sbalneav/rummikub-shot-clock/schematic/schematic.pdf

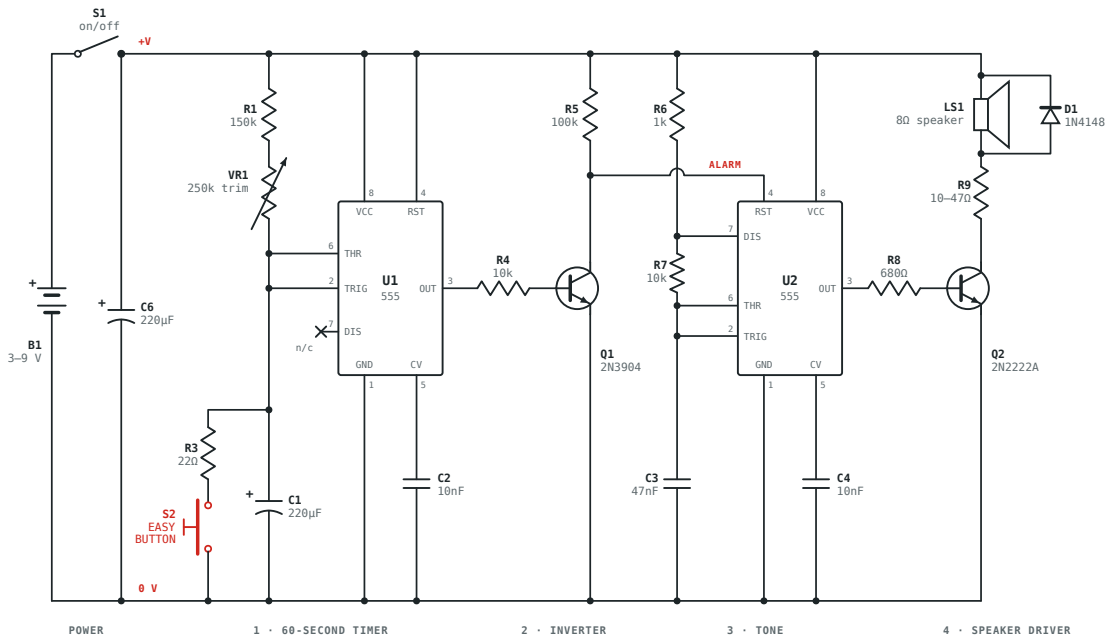
[picture p5: page 1]
