sbalneav/rummikub-shot-clock/pcb/rummikub-shot-clock.kicad_pcb

## KiCad design pcb/rummikub-shot-clock.kicad_pcb (2026-11-11)

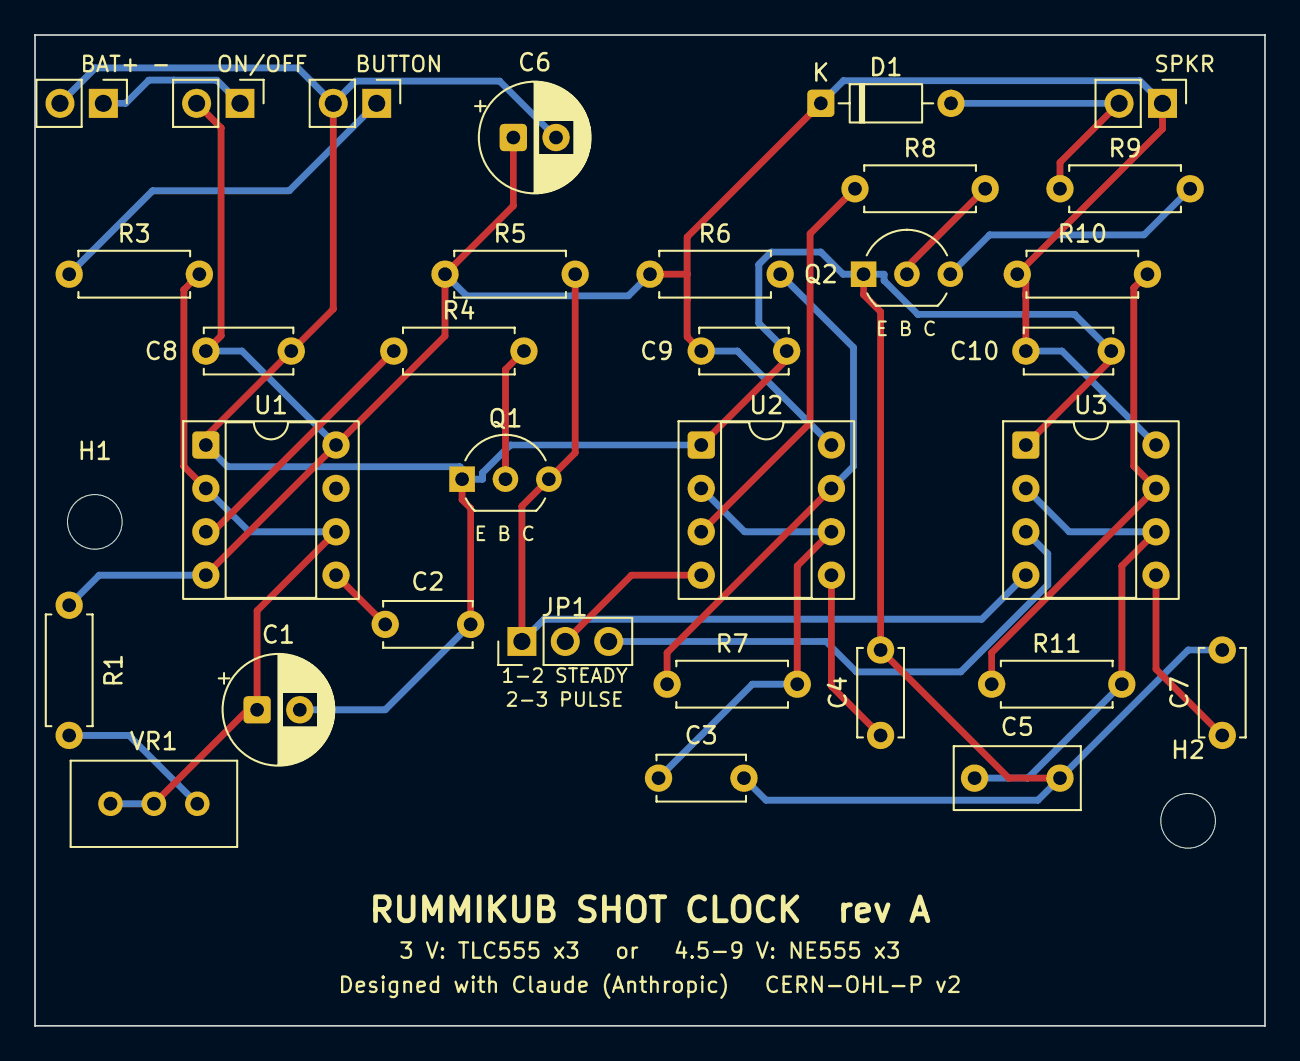
[picture p6: board rummikub-shot-clock.kicad_pcb from above]

Board: 2 copper layers, 72.0 x 58.0 mm, 34 parts (0 on the bottom side), 22 nets.

Parts:
C1, C6: 220uF; CP_Radial_D6.3mm_P2.50mm
C2, C4, C7: 10nF; C_Disc_D5.0mm_W2.5mm_P5.00mm
C3: 47nF; C_Disc_D5.0mm_W2.5mm_P5.00mm
C5: 1uF film; C_Rect_L7.2mm_W3.5mm_P5.00mm_FKS2_FKP2_MKS2_MKP2
C8, C9, C10: 100nF; C_Disc_D5.0mm_W2.5mm_P5.00mm
D1: 1N4148; D_DO-35_SOD27_P7.62mm_Horizontal
H1, H2: M3; MountingHole_3.2mm_M3
J1: BATTERY; PinHeader_1x02_P2.54mm_Vertical
J2: POWER_SW; PinHeader_1x02_P2.54mm_Vertical
J3: EASY_BTN; PinHeader_1x02_P2.54mm_Vertical
J4: SPEAKER; PinHeader_1x02_P2.54mm_Vertical
JP1: STEADY/PULSE; PinHeader_1x03_P2.54mm_Vertical
Q1: 2N3904; TO-92_Inline_Wide
Q2: 2N2222A; TO-92_Inline_Wide
R1: 150k; R_Axial_DIN0207_L6.3mm_D2.5mm_P7.62mm_Horizontal
R3: 22R; R_Axial_DIN0207_L6.3mm_D2.5mm_P7.62mm_Horizontal
R4, R7, R10: 10k; R_Axial_DIN0207_L6.3mm_D2.5mm_P7.62mm_Horizontal
R5: 100k; R_Axial_DIN0207_L6.3mm_D2.5mm_P7.62mm_Horizontal
R6: 1k; R_Axial_DIN0207_L6.3mm_D2.5mm_P7.62mm_Horizontal
R8: 680R; R_Axial_DIN0207_L6.3mm_D2.5mm_P7.62mm_Horizontal
R9: 10R; R_Axial_DIN0207_L6.3mm_D2.5mm_P7.62mm_Horizontal
R11: 330k; R_Axial_DIN0207_L6.3mm_D2.5mm_P7.62mm_Horizontal
U1, U2, U3: TLC555; DIP-8_W7.62mm_Socket
VR1: 250k; Potentiometer_Bourns_3296W_Vertical

Connections:
+3V: C6.1, C8.1, C9.1, C10.1, D1.1, J2.2, J4.1, R1.2, R5.1, R6.1, R10.1, U1.4, U1.8, U2.8, U3.8
ALARM: JP1.1, Q1.3, R5.2, U3.4
B1: Q1.2, R4.2
B2: Q2.2, R8.2
BTN: J3.1, R3.1
CV1: C2.1, U1.5
CV2: C4.1, U2.5
CV3: C7.1, U3.5
DIS2: R6.2, R7.1, U2.7
DIS3: R10.2, R11.1, U3.7
GND: C1.2, C2.2, C3.2, C4.2, C5.2, C6.2, C7.2, C8.2, C9.2, C10.2, J1.2, J3.2, Q1.1, Q2.1, U1.1, U2.1, U3.1
OUT1: R4.1, U1.3
OUT2: R8.1, U2.3
PULSE: JP1.3, U3.3
RST2: JP1.2, U2.4
RT1: R1.1, VR1.1
SPK_C: Q2.3, R9.2
SPK_N: D1.2, J4.2, R9.1
TH2: C3.1, R7.2, U2.2, U2.6
TH3: C5.1, R11.2, U3.2, U3.6
TIMING: C1.1, R3.2, U1.2, U1.6, VR1.2, VR1.3
VBAT: J1.1, J2.1
