sbalneav/rummikub-shot-clock/(notices)

Notices in the files:
pcb/rummikub-shot-clock.kicad_pcb:
Designed with Claude (Anthropic) CERN-OHL-P v2
